akowtko/PixieEscape/Coursework1Circuit.png

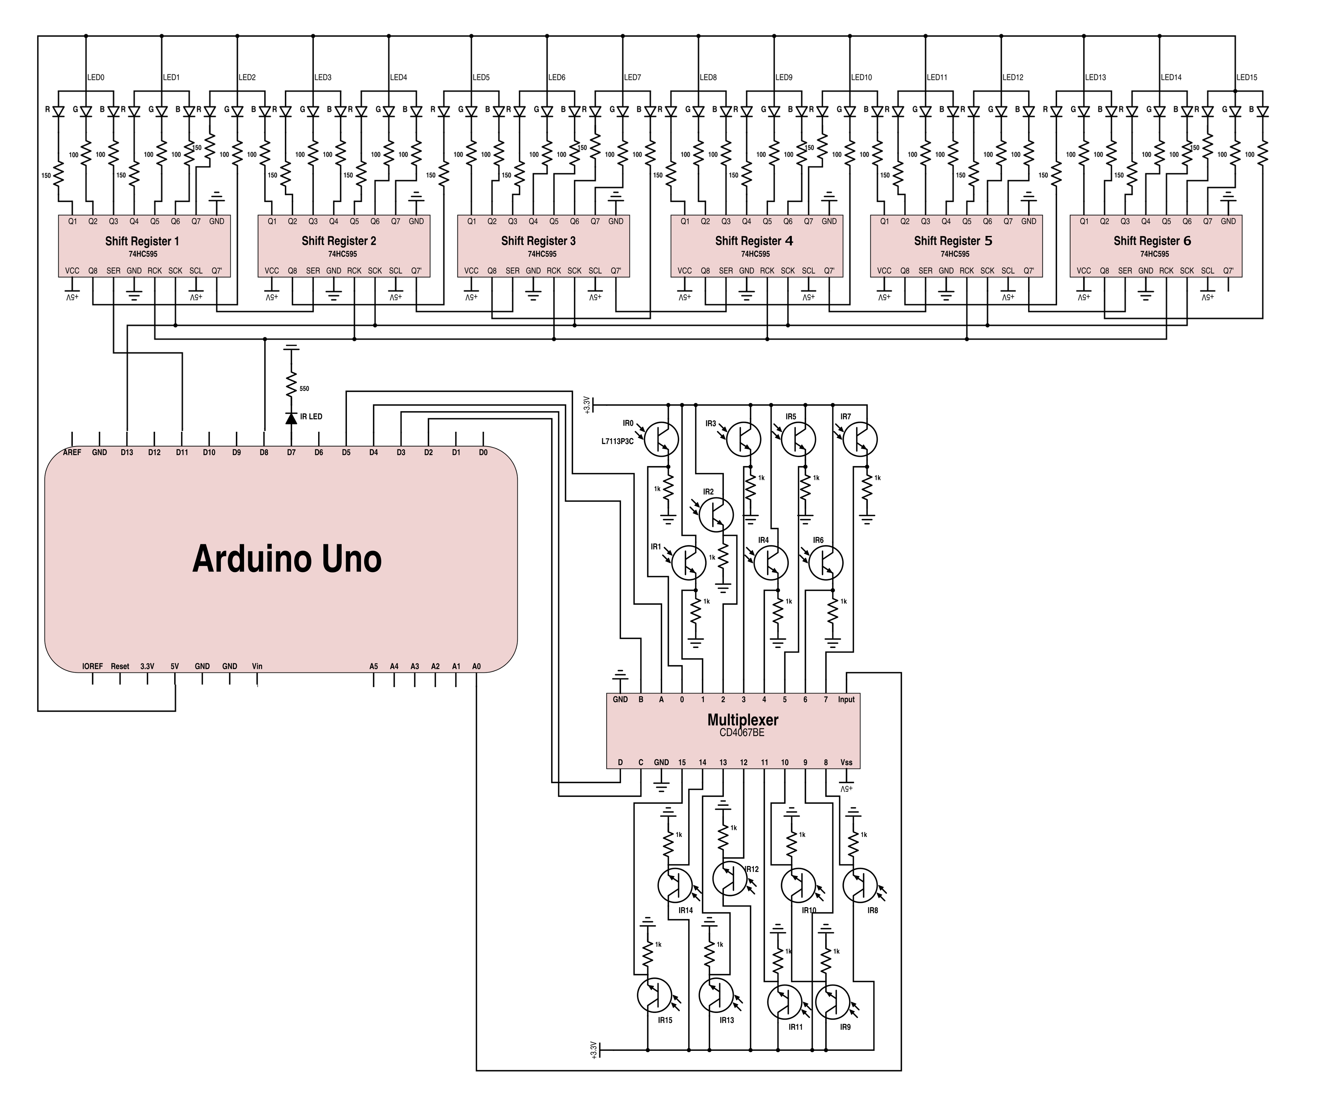
Coursework1Circuit.png
